albertovar/Z80-Retro-Computer/prompts/README.md

# Reusable prompts
- [Master prompt](master_prompt.md)
- [Hardware/KiCad review](hardware_review.md)
- [Firmware development](firmware_development.md)
- [Troubleshooting](troubleshooting.md)

Use these together with README, PROJECT_CONTEXT and architecture docs. Mark new decisions proposed until user confirms or tests validate.
