albertovar/Z80-Retro-Computer/hardware/pcb/README.md

# PCB
Add authoritative .kicad_pcb, revision and fabrication outputs as appropriate. Keep editable source separate from Gerbers/drills. Record revisions in changelog.
