albertovar/Z80-Retro-Computer/hardware/schematic/CPU.csv

Reference | Qty | Value | DNP | Exclude from BOM | Exclude from Board | Footprint | Datasheet
C3 | 1 | 47uF |  |  |  | Capacitor_THT:CP_Radial_D5.0mm_P2.00mm
C4 | 1 | 10nF |  |  |  | Capacitor_THT:C_Disc_D5.0mm_W2.5mm_P2.50mm
C5,C6,C7,C8,C9,C10,C11,C12,C13,C14,C15,C18,C19,C20,C21,C22 | 16 | 100nF |  |  |  | Capacitor_THT:C_Disc_D5.0mm_W2.5mm_P2.50mm
C16 | 1 | 10pF |  |  |  | Capacitor_THT:C_Disc_D5.0mm_W2.5mm_P2.50mm
C17 | 1 | 68pF |  |  |  | Capacitor_THT:C_Disc_D5.0mm_W2.5mm_P2.50mm
C23 | 1 | 470uF |  |  |  | Capacitor_THT:CP_Radial_D8.0mm_P5.00mm
D1 | 1 | SYSTEM HALT |  |  |  | LED_THT:LED_D1.8mm_W3.3mm_H2.4mm
DS2 | 1 | WC1602A |  |  |  | Display:WC1602A | http://www.wincomlcd.com/pdf/WC1602A-SFYLYHTC06.pdf
EXPANSION1 | 1 |  |  |  |  | Connector_IDC:IDC-Header_2x20_P2.54mm_Vertical
LED_BAR1 | 1 |  |  |  |  | Package_DIP:DIP-16_W7.62mm_LongPads | https://docs.broadcom.com/docs/AV02-1798EN
PORT_A1,PORT_B1,PORT_C1 | 3 |  |  |  |  | Connector_IDC:IDC-Header_2x05_P2.54mm_Vertical
POWER1 | 1 |  |  |  |  | Connector_Samtec_HPM_THT:Samtec_HPM-02-05-x-S_Straight_1x02_Pitch5.08mm
R1,R2,R3,R10 | 4 | 1K |  |  |  | Resistor_THT:R_Axial_DIN0204_L3.6mm_D1.6mm_P7.62mm_Horizontal
R4 | 1 | 47K |  |  |  | Resistor_THT:R_Axial_DIN0204_L3.6mm_D1.6mm_P7.62mm_Horizontal
R5,R6,R7,R8 | 4 | 10K |  |  |  | Resistor_THT:R_Axial_DIN0204_L3.6mm_D1.6mm_P7.62mm_Horizontal
R9 | 1 | 1M |  |  |  | Resistor_THT:R_Axial_DIN0204_L3.6mm_D1.6mm_P7.62mm_Horizontal
RESET1 | 1 |  |  |  |  | Button_Switch_THT:SW_SPST_Omron_B3F-40xx | https://www.apem.com/medias/download/MEC_switches_serie_MULTIMEC5E.pdf
RN1 | 1 | 10K |  |  |  | Package_DIP:DIP-16_W7.62mm_LongPads
RN2 | 1 | 1K |  |  |  | Package_DIP:DIP-16_W7.62mm_LongPads
RV1 | 1 | 47K |  |  |  | Potentiometer_THT:Potentiometer_ACP_CA9-V10_Vertical
SW1 | 1 |  |  |  |  | Button_Switch_THT:SW_DIP_SPSTx08_Piano_CTS_Series194-8MSTN_W7.62mm_P2.54mm
U1 | 1 | Z80 |  |  |  | Package_DIP:DIP-40_W15.24mm_Socket_LongPads | https://archive.org/details/zilog-z-8400
U2 | 1 | 74HC14 |  |  |  | Package_DIP:DIP-14_W10.16mm_LongPads | http://www.ti.com/lit/gpn/sn74HC14
U3 | 1 | ROM 28C256 |  |  |  | Socket:DIP_Socket-28_W11.9mm_W12.7mm_W15.24mm_W17.78mm_W18.5mm_3M_228-1277-00-0602J | http://ww1.microchip.com/downloads/en/DeviceDoc/doc0006.pdf
U4 | 1 | W24512AK |  |  |  | Package_DIP:DIP-32_W7.62mm | https://www.alldatasheet.es/datasheet-pdf/pdf/47634/WINBOND/W24512A.html
U5 | 1 | 74HC138 |  |  |  | Package_DIP:DIP-16_W7.62mm_LongPads | http://www.ti.com/lit/ds/symlink/cd74hc238.pdf
U6,U14 | 2 | 74HC273 |  |  |  | Package_DIP:DIP-20_W7.62mm_LongPads | https://assets.nexperia.com/documents/data-sheet/74HC_HCT273.pdf
U7 | 1 | 74HC04 |  |  |  | Package_DIP:DIP-14_W10.16mm_LongPads | https://assets.nexperia.com/documents/data-sheet/74HC_HCT04.pdf
U8 | 1 | L7805 |  |  |  | Package_TO_SOT_THT:TO-218-3_Horizontal_TabDown | http://www.st.com/content/ccc/resource/technical/document/datasheet/41/4f/b3/b0/12/d4/47/88/CD00000444.pdf/files/CD00000444.pdf/jcr:content/translations/en.CD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
U9 | 1 | 74HC08 |  |  |  | Package_DIP:DIP-14_W10.16mm_LongPads | http://www.ti.com/lit/gpn/sn74HC08
U10 | 1 | 74HC32 |  |  |  | Package_DIP:DIP-14_W10.16mm_LongPads | http://www.ti.com/lit/gpn/sn74HC32
U11 | 1 | 8250 |  |  |  | Package_DIP:DIP-40_W15.24mm_Socket_LongPads
U12 | 1 | 82C55A |  |  |  | Package_DIP:DIP-40_W15.24mm_Socket_LongPads | http://jap.hu/electronic/8255.pdf
U13 | 1 | 74HC02 |  |  |  | Package_DIP:DIP-14_W10.16mm_LongPads | http://www.ti.com/lit/gpn/sn74hc02
U15 | 1 | 74HC244 |  |  |  | Package_DIP:DIP-20_W7.62mm_LongPads | https://assets.nexperia.com/documents/data-sheet/74HC_HCT244.pdf
Y1 | 1 | 1.8432MHz |  |  |  | Crystal:Crystal_HC49-4H_Vertical
Y2 | 1 | 4MHz |  |  |  | Crystal:Crystal_HC49-4H_Vertical
