albertovar/Z80-Retro-Computer/firmware/tests/README.md

# Firmware Tests
Record planned/executed/passed/failed/inconclusive status, expected and actual behavior.
Suggested: reset/ROM boot, memory map/RAM, LCD, UART, switches-to-LED, monitor commands, CRC and ROM→RAM transition. Never mark passed without actual evidence.
