albertovar/Z80-Retro-Computer/hardware/schematic/CPU.kicad_pcb

## KiCad design hardware/schematic/CPU.kicad_pcb (2026-11-08)

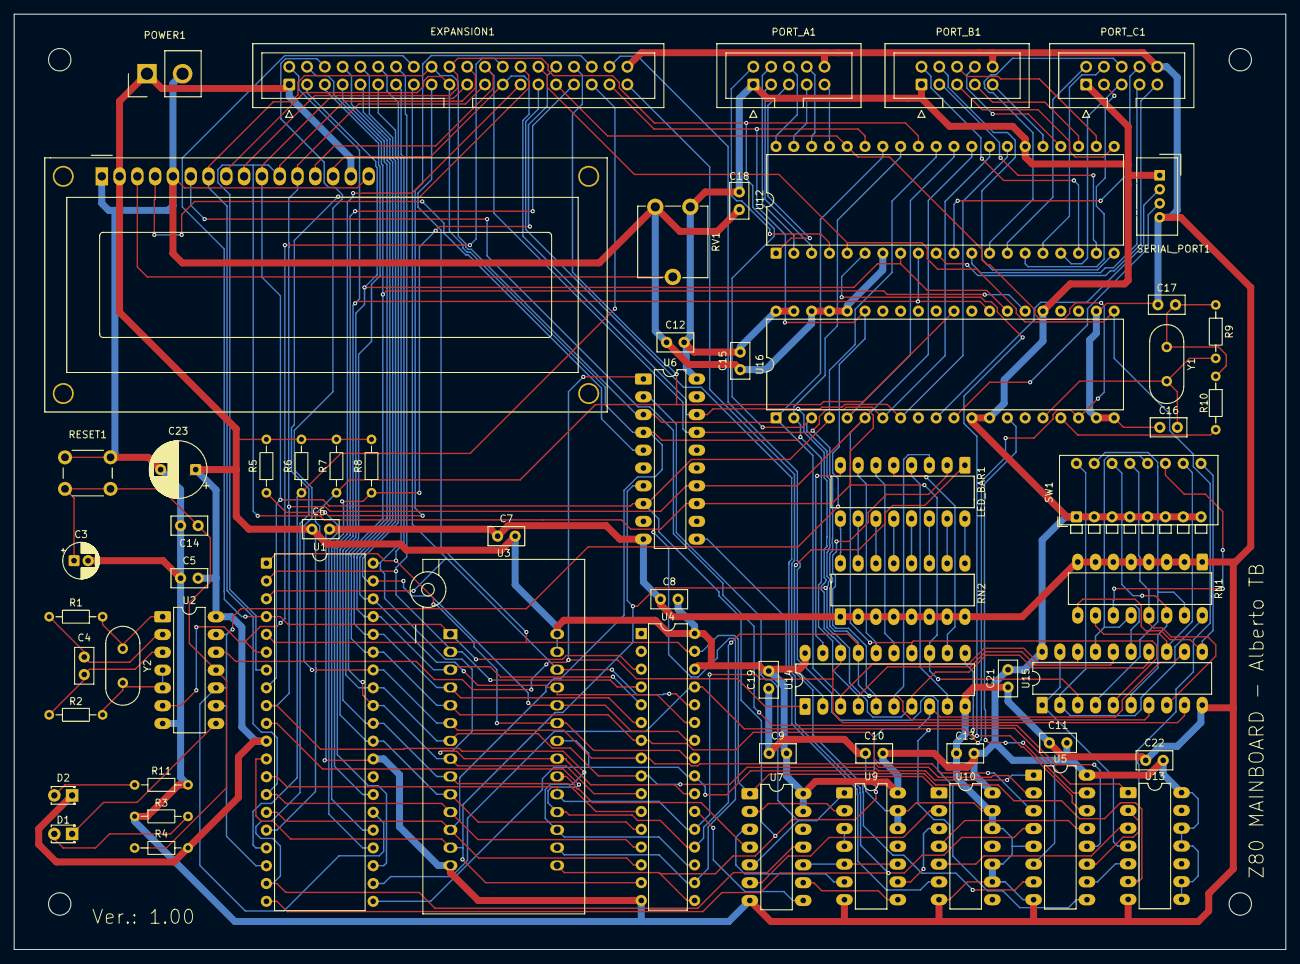
[picture p2: board CPU.kicad_pcb from above]

Board: 2 copper layers, 181.5 x 133.5 mm, 66 parts (0 on the bottom side), 124 nets.

Parts:
C3: 47uF; CP_Radial_D5.0mm_P2.00mm
C4: 10nF; C_Disc_D5.0mm_W2.5mm_P2.50mm
C5, C6, C7, C8, C9, C10, C11, C12, C13, C14, C15, C18, C19, C21, C22: 100nF; C_Disc_D5.0mm_W2.5mm_P2.50mm
C16: 10pF; C_Disc_D5.0mm_W2.5mm_P2.50mm
C17: 68pF; C_Disc_D5.0mm_W2.5mm_P2.50mm
C23: 470uF; CP_Radial_D8.0mm_P5.00mm
D1: SYSTEM HALT; LED_D1.8mm_W3.3mm_H2.4mm
D2: POWER_ON; LED_D1.8mm_W3.3mm_H2.4mm
DS2: WC1602A
EXPANSION1: IDC-Header_2x20_P2.54mm_Vertical
LED_BAR1: DIP-16_W7.62mm_LongPads
PORT_A1: IDC-Header_2x05_P2.54mm_Vertical
PORT_B1: IDC-Header_2x05_P2.54mm_Vertical
PORT_C1: IDC-Header_2x05_P2.54mm_Vertical
POWER1: Samtec_HPM-02-05-x-S_Straight_1x02_Pitch5.08mm
R1, R2, R3, R10, R11: 1K; R_Axial_DIN0204_L3.6mm_D1.6mm_P7.62mm_Horizontal
R4: 47K; R_Axial_DIN0204_L3.6mm_D1.6mm_P7.62mm_Horizontal
R5, R6, R7, R8: 10K; R_Axial_DIN0204_L3.6mm_D1.6mm_P7.62mm_Horizontal
R9: 1M; R_Axial_DIN0204_L3.6mm_D1.6mm_P7.62mm_Horizontal
REF1, REF2, REF3, REF4: MountingHole_3.2mm_M3
RESET1: SW_PUSH_6mm
RN1: 10K; DIP-16_W7.62mm_LongPads
RN2: 1K; DIP-16_W7.62mm_LongPads
RV1: 47K; Potentiometer_ACP_CA9-V10_Vertical
SERIAL_PORT1: NS-Tech_Grove_1x04_P2mm_Vertical
SW1: SW_DIP_SPSTx08_Piano_CTS_Series194-8MSTN_W7.62mm_P2.54mm
U1: Z80; DIP-40_W15.24mm
U2: 74HC14; DIP-14_W7.62mm_LongPads
U3: ROM 28C256; DIP_Socket-28_W11.9mm_W12.7mm_W15.24mm_W17.78mm_W18.5mm_3M_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
U4: W24512AK; DIP-32_W7.62mm
U5: 74HC138; DIP-16_W7.62mm_LongPads
U6, U14: 74HC273; DIP-20_W7.62mm_LongPads
U7: 74HC04; DIP-14_W7.62mm_LongPads
U9: 74HC08; DIP-14_W7.62mm_LongPads
U10: 74HC32; DIP-14_W7.62mm_LongPads
U12: 82C55A; DIP-40_W15.24mm
U13: 74HC02; DIP-14_W7.62mm_LongPads
U15: 74HC244; DIP-20_W7.62mm_LongPads
U16: 8250; DIP-40_W15.24mm
Y1: 1.8432MHz; Crystal_HC49-4H_Vertical
Y2: 4MHz; Crystal_HC49-4H_Vertical

Connections:
+5V: C5.2, C6.2, C7.2, C8.2, C9.2, C10.2, C11.2, C12.2, C13.2, C15.2, C18.2, C19.2, C21.2, C22.2, C23.1, D2.1 (K), DS2.2 (VDD), DS2.15 (LED(+)), EXPANSION1.1, PORT_A1.1, PORT_B1.1, PORT_C1.1, POWER1.1, R4.1, R5.2, R6.2, R7.2, R8.2, RV1.3, SERIAL_PORT1.1, SW1.1, SW1.2, SW1.3, SW1.4, SW1.5, SW1.6, SW1.7, SW1.8, U1.11 (V_{CC}), U2.14 (VCC), U3.27 (~WE), U3.28 (VCC), U4.30 (CS2), U4.32 (VCC), U5.6 (E2), U5.16 (VCC), U6.20 (VCC), U7.13, U7.14 (VCC), U9.14 (VCC), U10.14 (VCC), U12.26 (VCC), U13.8, U13.9, U13.11, U13.12, U13.14 (VCC), U14.20 (VCC), U15.20 (VCC), U16.12 (CS0), U16.13 (CS1), U16.25 (~ADS), U16.39 (~RI), U16.40 (VCC)
/IO_decoder/CONTROL_PORT_LOAD: U6.11 (Cp), U10.6
/Leds & Switchs/LED_PORT_LOAD: U13.1, U14.11 (Cp)
/Memory_decoder/MEM_ACCESS: U7.10, U9.5, U9.10
/Memory_decoder/RAM_SEL: U9.9, U10.3
/Memory_decoder/ROM_SEL: U9.3, U9.4
A0: EXPANSION1.2, U1.30 (A_{0}), U3.10 (A0), U4.12 (A0), U12.9 (A0), U16.28 (A0)
A1: EXPANSION1.3, U1.31 (A_{1}), U3.9 (A1), U4.11 (A1), U12.8 (A1), U16.27 (A1)
A2: EXPANSION1.4, U1.32 (A_{2}), U3.8 (A2), U4.10 (A2), U16.26 (A2)
A3: EXPANSION1.5, U1.33 (A_{3}), U3.7 (A3), U4.9 (A3), U5.1 (A0)
A4: EXPANSION1.6, U1.34 (A_{4}), U3.6 (A4), U4.8 (A4), U5.2 (A1)
A5: EXPANSION1.7, U1.35 (A_{5}), U3.5 (A5), U4.7 (A5), U5.3 (A2)
A6: EXPANSION1.8, U1.36 (A_{6}), U3.4 (A6), U4.6 (A6)
A7: EXPANSION1.9, U1.37 (A_{7}), U3.3 (A7), U4.5 (A7)
A8: EXPANSION1.10, U1.38 (A_{8}), U3.25 (A8), U4.27 (A8)
A9: EXPANSION1.11, U1.39 (A_{9}), U3.24 (A9), U4.26 (A9)
A10: EXPANSION1.12, U1.40 (A_{10}), U3.21 (A10), U4.23 (A10)
A11: EXPANSION1.13, U1.1 (A_{11}), U3.23 (A11), U4.25 (A11)
A12: EXPANSION1.14, U1.2 (A_{12}), U3.2 (A12), U4.4 (A12)
A13: EXPANSION1.15, U1.3 (A_{13}), U3.26 (A13), U4.28 (A13)
A14: EXPANSION1.16, U1.4 (A_{14}), U3.1 (A14), U4.3 (A14)
A15: EXPANSION1.17, U1.5 (A_{15}), U4.31 (A15), U7.1, U10.1
BUSACK: EXPANSION1.33, U1.23 (~BUSACK)
BUSREQ: EXPANSION1.32, R8.1, U1.25 (~BUSREQ)
CLK_CPU: EXPANSION1.26, U1.6 (CLK), U2.6
CONTROL_CS: U5.13 (~Y2), U10.4
D0: DS2.7 (D0), EXPANSION1.18, U1.14 (D_{0}), U3.11 (D0), U4.13 (D0), U6.3 (D0), U12.34 (D0), U14.3 (D0), U15.18 (1Y0), U16.1 (D0)
D1: DS2.8 (D1), EXPANSION1.19, U1.15 (D_{1}), U3.12 (D1), U4.14 (D1), U6.4 (D1), U12.33 (D1), U14.4 (D1), U15.16 (1Y1), U16.2 (D1)
D2: DS2.9 (D2), EXPANSION1.20, U1.12 (D_{2}), U3.13 (D2), U4.15 (D2), U6.7 (D2), U12.32 (D2), U14.7 (D2), U15.14 (1Y2), U16.3 (D2)
D3: DS2.10 (D3), EXPANSION1.21, U1.8 (D_{3}), U3.15 (D3), U4.17 (D3), U6.8 (D3), U12.31 (D3), U14.8 (D3), U15.12 (1Y3), U16.4 (D3)
D4: DS2.11 (D4), EXPANSION1.22, U1.7 (D_{4}), U3.16 (D4), U4.18 (D4), U6.13 (D4), U12.30 (D4), U14.13 (D4), U15.3 (2Y0), U16.5 (D4)
D5: DS2.12 (D5), EXPANSION1.23, U1.9 (D_{5}), U3.17 (D5), U4.19 (D5), U6.14 (D5), U12.29 (D5), U14.14 (D5), U15.5 (2Y1), U16.6 (D5)
D6: DS2.13 (D6), EXPANSION1.24, U1.10 (D_{6}), U3.18 (D6), U4.20 (D6), U6.17 (D6), U12.28 (D6), U14.17 (D6), U15.7 (2Y2), U16.7 (D6)
D7: DS2.14 (D7), EXPANSION1.25, U1.13 (D_{7}), U3.19 (D7), U4.21 (D7), U6.18 (D7), U12.27 (D7), U14.18 (D7), U15.9 (2Y3), U16.8 (D7)
EXPANSION_PORT_A: EXPANSION1.38, U5.9 (~Y6)
EXPANSION_PORT_B: EXPANSION1.39, U5.7 (~Y7)
GND: C3.2, C5.1, C6.1, C7.1, C8.1, C9.1, C10.1, C11.1, C12.1, C13.1, C14.1, C15.1, C16.2, C17.2, C18.1, C19.1, C21.1, C22.1, C23.2, DS2.1 (VSS), DS2.5 (R/W), DS2.16 (LED(-)), EXPANSION1.40, PORT_A1.10, PORT_B1.10, PORT_C1.10, POWER1.2, R3.1, R11.1, RESET1.1, RN1.1 (R1.1), RN1.2 (R2.1), RN1.3 (R3.1), RN1.4 (R4.1), RN1.5 (R5.1), RN1.6 (R6.1), RN1.7 (R7.1), RN1.8 (R8.1), RN2.1 (R1.1), RN2.2 (R2.1), RN2.3 (R3.1), RN2.4 (R4.1), RN2.5 (R5.1), RN2.6 (R6.1), RN2.7 (R7.1), RN2.8 (R8.1), RV1.1, SERIAL_PORT1.4, U1.29 (GND), U2.7 (GND), U3.14 (GND), U4.16 (VSS), U5.5 (~E1), U5.8 (GND), U6.10 (GND), U7.7 (GND), U9.7 (GND), U9.12, U9.13, U10.7 (GND), U10.9, U10.10, U10.12, U10.13, U12.7 (GND), U13.7 (GND), U14.10 (GND), U15.10 (GND), U16.19 (WR), U16.20 (GND), U16.22 (RD), U16.36 (~CTS), U16.37 (~DSR), U16.38 (~DCD)
HALT: U1.18 (~HALT), U2.9
INT: EXPANSION1.34, R7.1, U1.16 (~INT), U16.30 (INTR)
IORQ: EXPANSION1.29, U1.20 (~IORQ), U5.4 (~E0)
LCD_E: DS2.6 (E), U5.12 (~Y3)
LCD_RS: DS2.4 (RS), U6.5 (Q1)
LEDS_CS: U5.11 (~Y4), U13.2
M1: EXPANSION1.27, U1.27 (~M1)
MREQ: EXPANSION1.28, U1.19 (~MREQ), U7.11
NMI: EXPANSION1.35, R6.1, U1.17 (~NMI)
unnamed: C4.1, R1.2, U2.2
unnamed: C4.2, R2.1, U2.3
unnamed: C3.1, C14.2, R4.2, RESET1.2, U2.11
unnamed: C17.1, R9.1, R10.1, Y1.1
unnamed: D1.2 (A), R3.2
unnamed: D1.1 (K), U2.8
unnamed: D2.2 (A), R11.2
unnamed: DS2.3 (VO), RV1.2
unnamed: R1.1, U2.1, Y2.1
unnamed: R2.2, U2.4, U2.5, Y2.2
unnamed: RN1.16 (R1.2), SW1.16, U15.2 (1A0)
unnamed: RN1.15 (R2.2), SW1.15, U15.4 (1A1)
unnamed: RN1.14 (R3.2), SW1.14, U15.6 (1A2)
unnamed: RN1.13 (R4.2), SW1.13, U15.8 (1A3)
unnamed: RN1.12 (R5.2), SW1.12, U15.17 (2A0)
unnamed: RN1.11 (R6.2), SW1.11, U15.15 (2A1)
unnamed: RN1.10 (R7.2), SW1.10, U15.13 (2A2)
unnamed: RN1.9 (R8.2), SW1.9, U15.11 (2A3)
unnamed: LED_BAR1.9 (K), RN2.16 (R1.2)
unnamed: LED_BAR1.10 (K), RN2.15 (R2.2)
unnamed: LED_BAR1.11 (K), RN2.14 (R3.2)
unnamed: LED_BAR1.12 (K), RN2.13 (R4.2)
unnamed: LED_BAR1.13 (K), RN2.12 (R5.2)
unnamed: LED_BAR1.14 (K), RN2.11 (R6.2)
unnamed: LED_BAR1.15 (K), RN2.10 (R7.2)
unnamed: LED_BAR1.16 (K), RN2.9 (R8.2)
unnamed: U7.2, U9.2
unnamed: U7.3, U9.6
unnamed: U7.9, U9.8
unnamed: U7.6, U10.2
unnamed: LED_BAR1.1 (A), U14.2 (Q0)
unnamed: LED_BAR1.2 (A), U14.5 (Q1)
unnamed: LED_BAR1.3 (A), U14.6 (Q2)
unnamed: LED_BAR1.4 (A), U14.9 (Q3)
unnamed: LED_BAR1.5 (A), U14.12 (Q4)
unnamed: LED_BAR1.6 (A), U14.15 (Q5)
unnamed: LED_BAR1.7 (A), U14.16 (Q6)
unnamed: LED_BAR1.8 (A), U14.19 (Q7)
unnamed: U13.4, U15.1 (1OE), U15.19 (2OE)
unnamed: C16.1, R9.2, U16.16 (XIN), Y1.2
unnamed: R10.2, U16.17 (XOUT)
PA0: PORT_A1.2, U12.4 (PA0)
PA1: PORT_A1.3, U12.3 (PA1)
PA2: PORT_A1.4, U12.2 (PA2)
PA3: PORT_A1.5, U12.1 (PA3)
PA4: PORT_A1.6, U12.40 (PA4)
PA5: PORT_A1.7, U12.39 (PA5)
PA6: PORT_A1.8, U12.38 (PA6)
PA7: PORT_A1.9, U12.37 (PA7)
PB0: PORT_B1.2, U12.18 (PB0)
PB1: PORT_B1.3, U12.19 (PB1)
PB2: PORT_B1.4, U12.20 (PB2)
PB3: PORT_B1.5, U12.21 (PB3)
PB4: PORT_B1.6, U12.22 (PB4)
PB5: PORT_B1.7, U12.23 (PB5)
PB6: PORT_B1.8, U12.24 (PB6)
PB7: PORT_B1.9, U12.25 (PB7)
PC0: PORT_C1.2, U12.14 (PC0)
PC1: PORT_C1.3, U12.15 (PC1)
PC2: PORT_C1.4, U12.16 (PC2)
PC3: PORT_C1.5, U12.17 (PC3)
PC4: PORT_C1.6, U12.13 (PC4)
PC5: PORT_C1.7, U12.12 (PC5)
PC6: PORT_C1.8, U12.11 (PC6)
PC7: PORT_C1.9, U12.10 (PC7)
PPI_CS: U5.14 (~Y1), U12.6 (~CS)
RAM_CS: U4.22 (~CS1), U7.8
RD: EXPANSION1.30, U1.21 (~RD), U3.22 (~OE), U4.24 (~OE), U12.5 (~RD), U13.6, U16.21 (~RD)
RESET: EXPANSION1.37, U1.26 (~RESET), U2.10, U2.13, U12.35 (RESET), U16.35 (MR)
RESET_INV: U2.12, U6.1 (~Mr), U14.1 (~Mr)
ROM_CS: U3.20 (~CS), U7.4
ROM_ENABLE: U6.2 (Q0), U7.5, U9.1
SERIAL-RX: SERIAL_PORT1.2, U16.10 (SIN)
SERIAL-TX: SERIAL_PORT1.3, U16.11 (SOUT)
SWITCH_CS: U5.10 (~Y5), U13.5
UART_CS: U5.15 (~Y0), U16.14 (~CS2)
WAIT: EXPANSION1.36, R5.1, U1.24 (~WAIT)
WR: EXPANSION1.31, U1.22 (~WR), U4.29 (~WE), U10.5, U12.36 (~WR), U13.3, U16.18 (~WR)
