albertovar/Z80-Retro-Computer/(commit log)

2026-11-08 docs: add WD8250 UART documentation
2026-11-08 docs: add schematic import instructions
2026-11-08 docs: add PCB import instructions
2026-11-08 Add TODO items for PPI, ROM-to-RAM switch, and CP/M
